EloRSL/Meritev-hitrosti-padanja/docs/skica_projekta.png

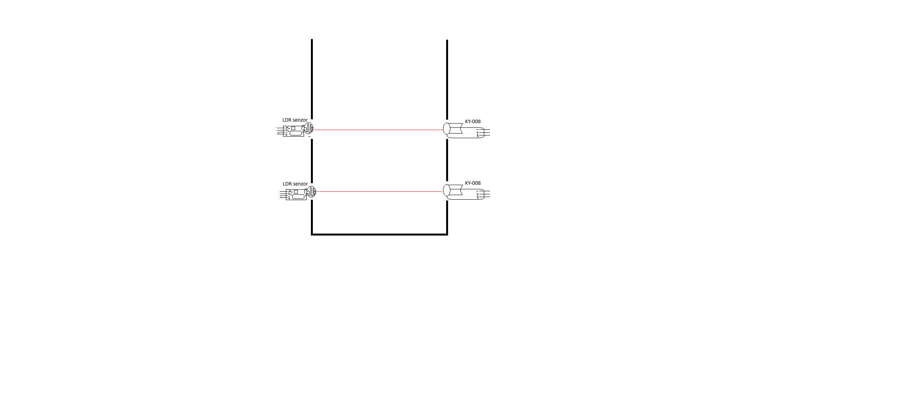
docs/skica_projekta.png
